neils95/Trivio/README.md

# Trivio
<h2>Boston University<br>
Jacob Dansey, Changshuo Fu, Christine Low, Urvashi Mohnani, Neil Sanghrajka</h2>
<br>

<h2>ReadMe Files</h2>

<h3>ReadmeFirst.docx</h3>
<p>Engineering Addendum outlining how to recreate our project.</p>

<h3>SoftwareREADME.md</h3>
<p>Documentation of the software components of our project.</p>

<h3>HardwareReadme.docx</h3>
<p>Documentation of the hardware components of our project.</p>

<br><br>
<h2>Folders</h2>

<h3>CAD Design</h3>
<p>Holds the Solidworks and STL files of the Trivio toy shell design.</p>

<h3>PCB Files</h3>
<p>Files related to PCB design and printing</p>

<h3>Reports</h3>
<p>Trivio Reports which include:</p>
<ul>
<li>Customer Installation Repor</li>
<li>First Deliverable Test Plan</li>
<li>First Deliverable Testing Report</li>
<li>First Semester Progress Report</li>
<li>Functional Testing Plan</li>
<li>Functional Testing Report</li>
<li>Gantchart</li>
<li>PDRR Report</li>
<li>Second Deliverable Test Plan</li>
<li>Second Deliverable Test Report</li>
<li>User's Manual</li>
</ul>

<h3>Server</h3>
<p>Code for the server</p>

<h3>Trivio Android App</h3>
<p>Code for the android application</p>

<h3>iOS_App</h3>
<p>Code for the iOS app</p>

<h3>Microprocessor</h3>
<p>Contains the Arduino code for the Trivio toy and the necessary libraries it uses.</p>
