neils95/Trivio/CAD Design/CAD Layout.pdf

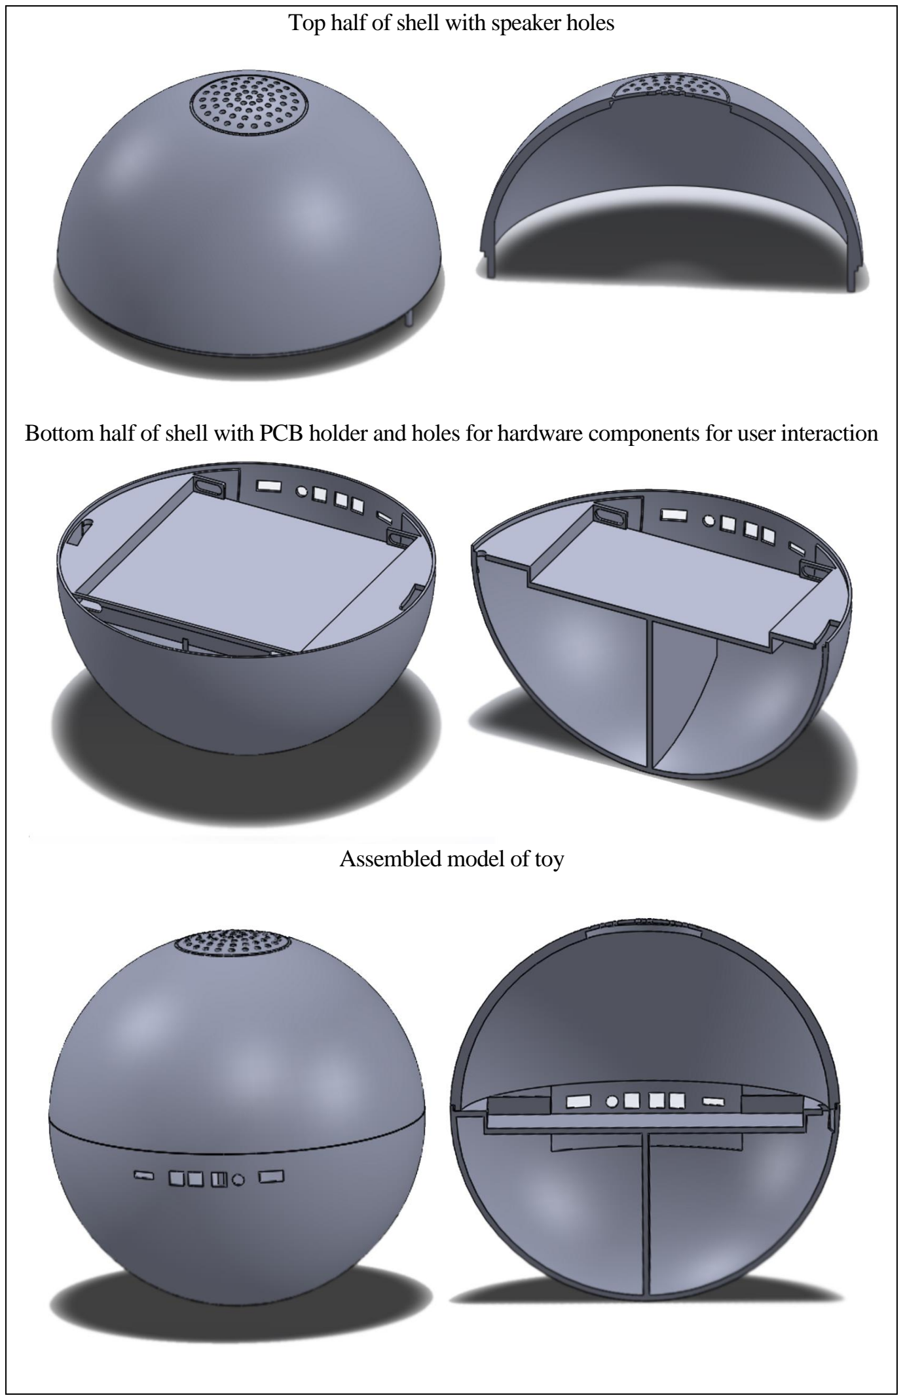
[picture p10: page 1]

Top half of shell with speaker holes

Bottom half of shell with PCB holder and holes for hardware components for user interaction

Assembled model of toy
