neils95/Trivio/Reports/Gantchart.docx

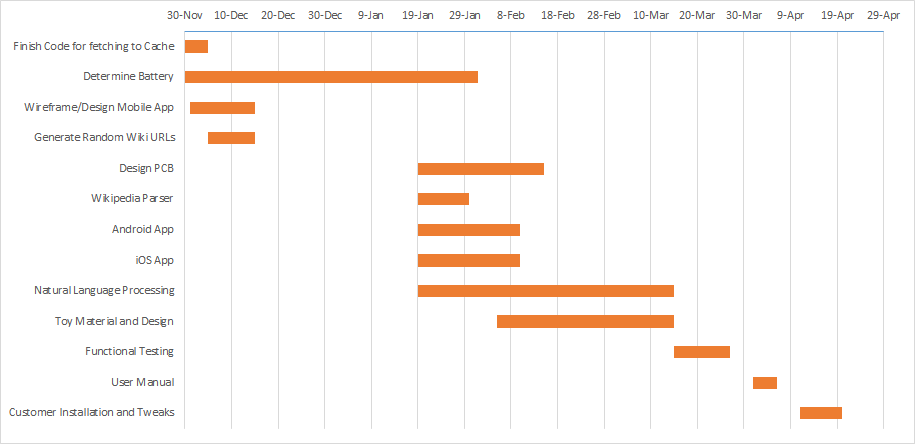
[picture p14: figure]
