neils95/Trivio/CAD Design/speakermount2.SLDPRT

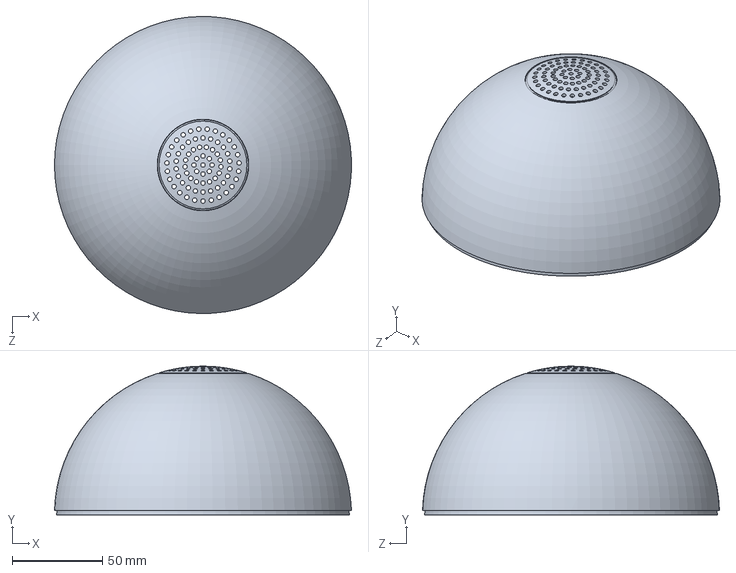
[picture p15: CAD file, 2017-04-26]
CAD Design/speakermount2.SLDPRT
164.5 x 82.3 x 164.5 mm
