neils95/Trivio/CAD Design/pcbmountshell.SLDPRT

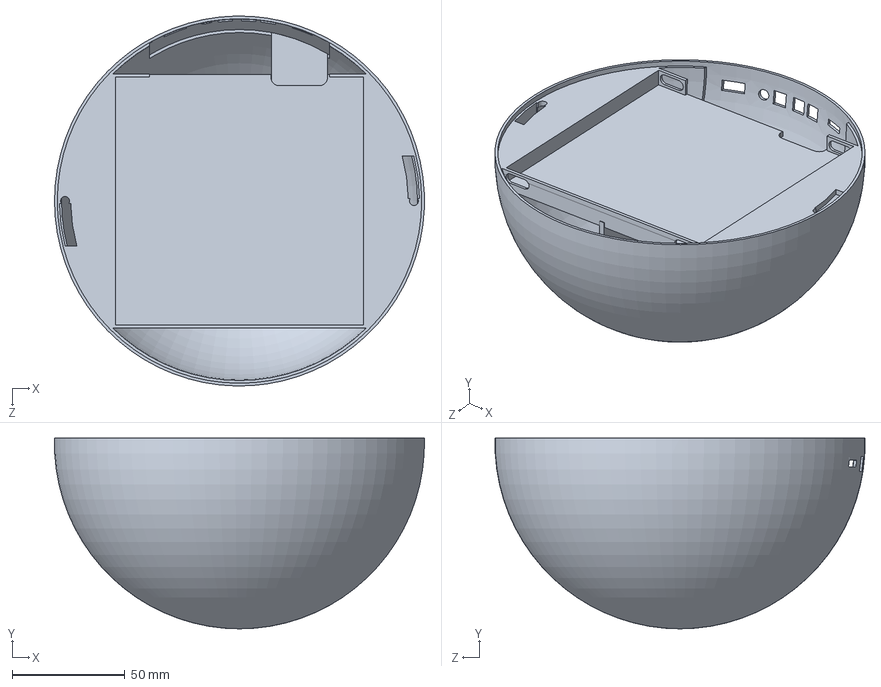
[picture p16: CAD file, 2017-04-26]
CAD Design/pcbmountshell.SLDPRT
164.4 x 84.8 x 164.4 mm
