neils95/Trivio/(list of files, cad)

Other CAD files:
CAD Design/speakermount.STL
CAD Design/pcbmountshell.STL
