neils95/Trivio/Server/Trivio/obj/Debug/_WPPLastBuildInfo.txt

PlatformName=AnyCPU
Configuration=Debug
WPPAllFilesInSingleFolder=C:\Users\neils\Documents\BU\Spring 2017\EC464\Code\Trivio\Server\Trivio\obj\Debug\Package\PackageTmp
WebPublishProfileFile=C:\Users\neils\Documents\BU\Spring 2017\EC464\Code\Trivio\Server\Trivio\Properties\PublishProfiles\Trivio - Web Deploy.pubxml
