neils95/Trivio/Server/Trivio/obj/Release/_WPPLastBuildInfo.txt

PlatformName=AnyCPU
Configuration=Release
WPPAllFilesInSingleFolder=C:\Users\neils\Documents\BU\Spring 2017\EC464\Code\Trivio\Server\Trivio\obj\Release\Package\PackageTmp
WebPublishProfileFile=C:\Users\neils\Documents\BU\Spring 2017\EC464\Code\Trivio\Server\Trivio\Properties\PublishProfiles\TrivioToy - Web Deploy (2).pubxml
