neils95/Trivio/(list of files, drawings)

Other design files:
PCB Files/PCB1.PcbDoc
PCB Files/PCB_Project.PrjPcb
PCB Files/Sheet3.SchDoc
PCB Files/Sheet4.SchDoc
