neils95/Trivio/microprocessor/ESP8266.cpp

/**
   @file ESP8266.cpp
   @brief The implementation of class ESP8266.
   @author Wu Pengfei<pengfei.wu@itead.cc>
   @date 2015.02

   @par Copyright:
   Copyright (c) 2015 ITEAD Intelligent Systems Co., Ltd. \n\n
   This program is free software; you can redistribute it and/or
   modify it under the terms of the GNU General Public License as
   published by the Free Software Foundation; either version 2 of
   the License, or (at your option) any later version. \n\n
   THE SOFTWARE IS PROVIDED "AS IS", WITHOUT WARRANTY OF ANY KIND, EXPRESS OR
   IMPLIED, INCLUDING BUT NOT LIMITED TO THE WARRANTIES OF MERCHANTABILITY,
   FITNESS FOR A PARTICULAR PURPOSE AND NONINFRINGEMENT. IN NO EVENT SHALL THE
   AUTHORS OR COPYRIGHT HOLDERS BE LIABLE FOR ANY CLAIM, DAMAGES OR OTHER
   LIABILITY, WHETHER IN AN ACTION OF CONTRACT, TORT OR OTHERWISE, ARISING FROM,
   OUT OF OR IN CONNECTION WITH THE SOFTWARE OR THE USE OR OTHER DEALINGS IN
   THE SOFTWARE.
*/
#include "ESP8266.h"

#define LOG_OUTPUT_DEBUG            (1)
#define LOG_OUTPUT_DEBUG_PREFIX     (1)

#define logDebug(arg)\
  do {\
    if (LOG_OUTPUT_DEBUG)\
    {\
      if (LOG_OUTPUT_DEBUG_PREFIX)\
      {\
        Serial.print("[LOG Debug: ");\
        Serial.print((const char*)__FILE__);\
        Serial.print(",");\
        Serial.print((unsigned int)__LINE__);\
        Serial.print(",");\
        Serial.print((const char*)__FUNCTION__);\
        Serial.print("] ");\
      }\
      Serial.print(arg);\
    }\
  } while(0)

#ifdef ESP8266_USE_SOFTWARE_SERIAL
ESP8266::ESP8266(SoftwareSerial &uart, uint32_t baud): m_puart(&uart)
{

}
#else
ESP8266::ESP8266(HardwareSerial &uart, uint32_t baud): m_puart(&uart)
{
  m_puart->begin(baud);
  rx_empty();
}
#endif

bool ESP8266::autoSetBaud(uint32_t baudRateSet)
{
  rx_empty();
  long time0 = millis();
  long baudRateArray[] = {9600, 19200, 57600, 115200}; //These are the optional default baudrates
  const int attempts = 5;
  bool baudFlag = 0;

#ifndef ESP8266_USE_SOFTWARE_SERIAL
  baudRateSet = 115200;                         //for hardware serial set to highest baudrate
#endif

  for (int j = 0 ; j < attempts ; j++) {                    //attempt to connect to esp over each baudrate
    for (int i = 0; i < sizeof(baudRateArray) ; i++)        //check for current esp baudrate
    {
      m_puart->begin(baudRateArray[i]);

      m_puart->println("AT");
      delay(20);
      while (m_puart->available()) {
        String inData = m_puart->readStringUntil('\n');
        if (inData.indexOf("OK") != -1) {       //if OK received, this is the current baudrate of the ESP
          baudFlag = 1;
          delay(15);
          break;
        }

      }
      if (baudFlag)
        break;
    }
    // ESP current BaudRate was found, now try to set it to 9600
    if (baudFlag) {
      baudFlag = 0;
      for (int j = 0; j < attempts; j++)               //at the found baudrate,
      {
        m_puart->print("AT+CIOBAUD=");
        m_puart->println(baudRateSet);
        delay(20);
        while (m_puart->available()) {
          String inData = m_puart->readStringUntil('\n');
          if (inData.indexOf("OK") != -1 || inData.indexOf("AT") != -1) {
            baudFlag = 1;
            m_puart->begin(baudRateSet);
            delay(100);
            return 1;
          }

        }
        if (baudFlag)
          break;
      }
    }

    if (baudFlag)
      break;
  }
  return 0;

}

//when using software serial BaudRate should be lower than 115200. 9600 works reliably
bool ESP8266::init(const String &ssid, const String &pwd, uint32_t baudRateSet)
{
  if (autoSetBaud(baudRateSet))
  {
    Serial.println("Baudrate set success");
  }
  else
  {
    Serial.println("Baudrate set failed");
    return false;
  }

  //Setting operation mode to Station + SoftAP
  if (setOprToStationSoftAP())
  {
    Serial.println("Station + softAP - OK");
  }
  else
  {
    Serial.println("Station + softAP - Error, Reset Board!");
    return false;
  }

  if (joinAP(ssid, pwd))
  {
    Serial.print("Joining AP successful, ");
    Serial.println(getLocalIP().c_str());
  }
  else
  {
    Serial.println("Join AP failure, Reset Board!");
    return false;
  }

  if (disableMUX())
  {
    Serial.println("Single Mode OK");
  }
  else
  {
    Serial.println("Single Mode Error, Reset Board!");
    return false;
  }
  return true;
}


bool ESP8266::kick(void)
{
  return eAT();
}

bool ESP8266::restart(void)
{
  unsigned long start;
  if (eATRST()) {
    delay(2000);
    start = millis();
    while (millis() - start < 3000) {
      if (eAT()) {
        delay(1500); /* Waiting for stable */
        return true;
      }
      delay(100);
    }
  }
  return false;
}

String ESP8266::getVersion(void)
{
  rx_empty();

  String inData;
  m_puart->println("AT+GMR");
  delay(50);
  while (m_puart->available() > 0) {
    inData = m_puart->readString();
    delay(50);
    if (inData.indexOf("version") != -1) {

      return inData.substring(6);    //cut version out of string
    }
  }
  return inData;


  String version;
  eATGMR(version);
  return version;
}

bool ESP8266::setOprToStation(void)
{
  uint8_t mode;
  if (!qATCWMODE(&mode)) {
    return false;
  }
  if (mode == 1) {
    return true;
  } else {
    if (sATCWMODE(1) && restart()) {
      return true;
    } else {
      return false;
    }
  }
}

bool ESP8266::setOprToSoftAP(void)
{
  uint8_t mode;
  if (!qATCWMODE(&mode)) {
    return false;
  }
  if (mode == 2) {
    return true;
  } else {
    if (sATCWMODE(2) && restart()) {
      return true;
    } else {
      return false;
    }
  }
}

bool ESP8266::setOprToStationSoftAP(void)
{
  uint8_t mode;
  if (!qATCWMODE(&mode)) {
    return false;
  }
  if (mode == 3) {
    return true;
  } else {
    if (sATCWMODE(3) && restart()) {
      return true;
    } else {
      return false;
    }
  }
}

String ESP8266::getAPList(void)
{
  String list;
  eATCWLAP(list);
  return list;
}

bool ESP8266::joinAP(String ssid, String pwd)
{
  return sATCWJAP(ssid, pwd);
}

bool ESP8266::leaveAP(void)
{
  return eATCWQAP();
}

bool ESP8266::setSoftAPParam(String ssid, String pwd, uint8_t chl, uint8_t ecn)
{
  return sATCWSAP(ssid, pwd, chl, ecn);
}

String ESP8266::getJoinedDeviceIP(void)
{
  String list;
  eATCWLIF(list);
  return list;
}

String ESP8266::getIPStatus(void)
{
  String list;
  eATCIPSTATUS(list);
  return list;
}

String ESP8266::getLocalIP(void)
{

  String inData;

  rx_empty();
  m_puart->println("AT+CIFSR");
  delay(50);
  while (m_puart->available() > 0) {
    inData = m_puart->readStringUntil('\n');
    if (inData.indexOf("IP") != -1) {
      delay(100);
      return ("IP: " + inData.substring( inData.indexOf("IP") + 4, inData.length() - 2 ));
    }
  }
  return "Couldn't get IP adress";

}

bool ESP8266::enableMUX(void)
{
  return sATCIPMUX(1);
}

bool ESP8266::disableMUX(void)
{
  rx_empty();
#ifdef ESP8266_USE_SOFTWARE_SERIAL
  String inData;
  m_puart->println("AT+CIPMUX=0");
  delay(50);
  while (m_puart->available() > 0) {
    inData = m_puart->readStringUntil('\n');
    if (inData.indexOf("OK") != -1) {
      delay(100);
      return true;
    }
  }
  return false;
#else
  return sATCIPMUX(0);
#endif

}

bool ESP8266::createTCP(String addr, uint32_t port)
{
  return sATCIPSTARTSingle("TCP", addr, port);
}


bool ESP8266::releaseTCP(void)
{
  rx_empty();
#ifdef ESP8266_USE_SOFTWARE_SERIAL

  String inData;
  m_puart->println("AT+CIPCLOSE");
  delay(50);
  while (m_puart->available() > 0) {
    inData = m_puart->readString();
    if (inData.indexOf("OK") != -1) {
      delay(100);
      return 1;
    }
  }
  return 0;
#else
  return eATCIPCLOSESingle();
#endif
}

bool ESP8266::registerUDP(String addr, uint32_t port)
{
  return sATCIPSTARTSingle("UDP", addr, port);
}

bool ESP8266::unregisterUDP(void)
{
  return eATCIPCLOSESingle();
}

bool ESP8266::createTCP(uint8_t mux_id, String addr, uint32_t port)
{
  return sATCIPSTARTMultiple(mux_id, "TCP", addr, port);
}

bool ESP8266::releaseTCP(uint8_t mux_id)
{
  return sATCIPCLOSEMulitple(mux_id);
}

bool ESP8266::registerUDP(uint8_t mux_id, String addr, uint32_t port)
{
  return sATCIPSTARTMultiple(mux_id, "UDP", addr, port);
}

bool ESP8266::unregisterUDP(uint8_t mux_id)
{
  return sATCIPCLOSEMulitple(mux_id);
}

bool ESP8266::setTCPServerTimeout(uint32_t timeout)
{
  return sATCIPSTO(timeout);
}

bool ESP8266::startTCPServer(uint32_t port)
{
  if (sATCIPSERVER(1, port)) {
    return true;
  }
  return false;
}

bool ESP8266::stopTCPServer(void)
{
  sATCIPSERVER(0);
  restart();
  return false;
}

bool ESP8266::startServer(uint32_t port)
{
  return startTCPServer(port);
}

bool ESP8266::stopServer(void)
{
  return stopTCPServer();
}

bool ESP8266::send(const uint8_t *buffer, uint32_t len)
{
  return sATCIPSENDSingle(buffer, len);
}



bool ESP8266::send(uint8_t mux_id, const uint8_t *buffer, uint32_t len)
{
  return sATCIPSENDMultiple(mux_id, buffer, len);
}

uint32_t ESP8266::recv(uint8_t *buffer, uint32_t buffer_size, uint32_t timeout)
{
  return recvPkg(buffer, buffer_size, NULL, timeout, NULL);
}



uint32_t ESP8266::recv(uint8_t mux_id, uint8_t *buffer, uint32_t buffer_size, uint32_t timeout)
{
  uint8_t id;
  uint32_t ret;
  ret = recvPkg(buffer, buffer_size, NULL, timeout, &id);
  if (ret > 0 && id == mux_id) {
    return ret;
  }
  return 0;
}

uint32_t ESP8266::recv(uint8_t *coming_mux_id, uint8_t *buffer, uint32_t buffer_size, uint32_t timeout)
{
  return recvPkg(buffer, buffer_size, NULL, timeout, coming_mux_id);
}

/*----------------------------------------------------------------------------*/
/* +IPD,<id>,<len>:<data> */
/* +IPD,<len>:<data> */

uint32_t ESP8266::recvPkg(uint8_t *buffer, uint32_t buffer_size, uint32_t *data_len, uint32_t timeout, uint8_t *coming_mux_id)
{
  String data;
  char a;
  int32_t index_PIPDcomma = -1;
  int32_t index_colon = -1; /* : */
  int32_t index_comma = -1; /* , */
  int32_t len = -1;
  int8_t id = -1;
  bool has_data = false;
  uint32_t ret;
  unsigned long start;
  uint32_t i;

  if (buffer == NULL) {
    return 0;
  }

  start = millis();
  while (millis() - start < timeout) {
    if (m_puart->available() > 0) {
      a = m_puart->read();
      data += a;
    }

    index_PIPDcomma = data.indexOf("+IPD,");
    if (index_PIPDcomma != -1) {
      index_colon = data.indexOf(':', index_PIPDcomma + 5);
      if (index_colon != -1) {
        index_comma = data.indexOf(',', index_PIPDcomma + 5);
        /* +IPD,id,len:data */
        if (index_comma != -1 && index_comma < index_colon) {
          id = data.substring(index_PIPDcomma + 5, index_comma).toInt();
          if (id < 0 || id > 4) {
            return 0;
          }
          len = data.substring(index_comma + 1, index_colon).toInt();
          if (len <= 0) {
            return 0;
          }
        } else { /* +IPD,len:data */
          len = data.substring(index_PIPDcomma + 5, index_colon).toInt();
          if (len <= 0) {
            return 0;
          }
        }
        has_data = true;
        break;
      }
    }
  }

  if (has_data) {
    i = 0;
    ret = len > buffer_size ? buffer_size : len;
    start = millis();
    while (millis() - start < 3000) {
      while (m_puart->available() > 0 && i < ret) {
        a = m_puart->read();
        buffer[i++] = a;
      }
      if (i == ret) {
        rx_empty();
        if (data_len) {
          *data_len = len;
        }
        if (index_comma != -1 && coming_mux_id) {
          *coming_mux_id = id;
        }
        return ret;
      }
    }
  }
  return 0;
}

void ESP8266::rx_empty(void)
{
  while (m_puart->available() > 0) {
    m_puart->read();
  }
}

String ESP8266::recvString(String target, uint32_t timeout)
{
  String data;
  char a;
  unsigned long start = millis();
  while (millis() - start < timeout) {
    while (m_puart->available() > 0) {
      a = m_puart->read();
      if (a == '\0') continue;
      data += a;
    }
    if (data.indexOf(target) != -1) {
      break;
    }
  }
  return data;
}

String ESP8266::recvString(String target1, String target2, uint32_t timeout)
{
  String data;
  char a;
  unsigned long start = millis();
  while (millis() - start < timeout) {
    while (m_puart->available() > 0) {
      a = m_puart->read();
      if (a == '\0') continue;
      data += a;
    }
    if (data.indexOf(target1) != -1) {
      break;
    } else if (data.indexOf(target2) != -1) {
      break;
    }
  }
  return data;
}

String ESP8266::recvString(String target1, String target2, String target3, uint32_t timeout)
{
  String data;
  char a;
  unsigned long start = millis();
  while (millis() - start < timeout) {
    while (m_puart->available() > 0) {
      a = m_puart->read();
      if (a == '\0') continue;
      data += a;
    }
    if (data.indexOf(target1) != -1) {
      break;
    } else if (data.indexOf(target2) != -1) {
      break;
    } else if (data.indexOf(target3) != -1) {
      break;
    }
  }
  return data;
}

bool ESP8266::recvFind(String target, uint32_t timeout)
{
  String data_tmp;
  data_tmp = recvString(target, timeout);
  if (data_tmp.indexOf(target) != -1) {
    return true;
  }
  return false;
}

bool ESP8266::recvFindAndFilter(String target, String begin, String end, String & data, uint32_t timeout)
{
  String data_tmp;
  data_tmp = recvString(target, timeout);
  if (data_tmp.indexOf(target) != -1) {
    int32_t index1 = data_tmp.indexOf(begin);
    int32_t index2 = data_tmp.indexOf(end);
    if (index1 != -1 && index2 != -1) {
      index1 += begin.length();
      data = data_tmp.substring(index1, index2);
      return true;
    }
  }
  data = "";
  return false;
}

bool ESP8266::eAT(void)
{
  rx_empty();
  m_puart->println("AT");
  return recvFind("OK");
}

bool ESP8266::eATRST(void)
{
  rx_empty();
  m_puart->println("AT+RST");
  return recvFind("OK");
}

bool ESP8266::eATGMR(String & version)
{
  rx_empty();
  m_puart->println("AT+GMR");
  return recvFindAndFilter("OK", "\r\r\n", "\r\n\r\nOK", version);
}

bool ESP8266::qATCWMODE(uint8_t *mode)
{
  String str_mode;
  bool ret;
  if (!mode) {
    return false;
  }
  rx_empty();
  m_puart->println("AT+CWMODE?");
  ret = recvFindAndFilter("OK", "+CWMODE:", "\r\n\r\nOK", str_mode);
  if (ret) {
    *mode = (uint8_t)str_mode.toInt();
    return true;
  } else {
    return false;
  }
}

bool ESP8266::sATCWMODE(uint8_t mode)
{
  String data;
  rx_empty();
  m_puart->print("AT+CWMODE=");
  m_puart->println(mode);

  data = recvString("OK", "no change");
  if (data.indexOf("OK") != -1 || data.indexOf("no change") != -1) {
    return true;
  }
  return false;
}

bool ESP8266::sATCWJAP(String ssid, String pwd)
{
  String data;
  rx_empty();
  m_puart->print("AT+CWJAP=\"");
  m_puart->print(ssid);
  m_puart->print("\",\"");
  m_puart->print(pwd);
  m_puart->println("\"");

  data = recvString("OK", "FAIL", 10000);
  if (data.indexOf("OK") != -1) {
    return true;
  }
  return false;
}

bool ESP8266::eATCWLAP(String & list)
{
  String data;
  rx_empty();
  m_puart->println("AT+CWLAP");
  return recvFindAndFilter("OK", "\r\r\n", "\r\n\r\nOK", list, 10000);
}

bool ESP8266::eATCWQAP(void)
{
  String data;
  rx_empty();
  m_puart->println("AT+CWQAP");
  return recvFind("OK");
}

bool ESP8266::sATCWSAP(String ssid, String pwd, uint8_t chl, uint8_t ecn)
{
  String data;
  rx_empty();
  m_puart->print("AT+CWSAP=\"");
  m_puart->print(ssid);
  m_puart->print("\",\"");
  m_puart->print(pwd);
  m_puart->print("\",");
  m_puart->print(chl);
  m_puart->print(",");
  m_puart->println(ecn);

  data = recvString("OK", "ERROR", 5000);
  if (data.indexOf("OK") != -1) {
    return true;
  }
  return false;
}

bool ESP8266::eATCWLIF(String & list)
{
  String data;
  rx_empty();
  m_puart->println("AT+CWLIF");
  return recvFindAndFilter("OK", "\r\r\n", "\r\n\r\nOK", list);
}

bool ESP8266::eATCIPSTATUS(String & list)
{
  String data;
  delay(100);
  rx_empty();
  m_puart->println("AT+CIPSTATUS");
  return recvFindAndFilter("OK", "\r\r\n", "\r\n\r\nOK", list);
}

bool ESP8266::sATCIPSTARTSingle(String type, String addr, uint32_t port)
{
  String data;
  rx_empty();
  m_puart->print("AT+CIPSTART=\"");
  m_puart->print(type);
  m_puart->print("\",\"");
  m_puart->print(addr);
  m_puart->print("\",");
  m_puart->println(port);

  data = recvString("OK", "ERROR", "ALREADY CONNECT", 500);
  if (data.indexOf("OK") != -1 || data.indexOf("ALREADY CONNECT") != -1) {
    return true;
  }
  return false;
}

bool ESP8266::sATCIPSTARTMultiple(uint8_t mux_id, String type, String addr, uint32_t port)
{
  String data;
  rx_empty();
  delay(50);
  m_puart->print("AT+CIPSTART=");
  m_puart->print(mux_id);
  m_puart->print(",\"");
  m_puart->print(type);
  m_puart->print("\",\"");
  m_puart->print(addr);
  m_puart->print("\",");
  m_puart->println(port);

  data = recvString("OK", "ERROR", "ALREADY CONNECT", 10000);
  if (data.indexOf("OK") != -1 || data.indexOf("ALREADY CONNECT") != -1) {
    return true;
  }
  return false;
}

bool ESP8266::sATCIPSENDSingle(const uint8_t *buffer, uint32_t len)
{
  rx_empty();
  m_puart->print("AT+CIPSEND=");
  m_puart->println(len);
  if (recvFind(">", 5000)) {
    rx_empty();
    for (uint32_t i = 0; i < len; i++) {
      m_puart->write(buffer[i]);
    }
    return recvFind("SEND OK", 10000);
  }
  return false;
}

bool ESP8266::sATCIPSENDMultiple(uint8_t mux_id, const uint8_t *buffer, uint32_t len)
{
  rx_empty();
  m_puart->print("AT+CIPSEND=");
  m_puart->print(mux_id);
  m_puart->print(",");
  m_puart->println(len);
  if (recvFind(">", 5000)) {
    rx_empty();
    for (uint32_t i = 0; i < len; i++) {
      m_puart->write(buffer[i]);
    }
    return recvFind("SEND OK", 10000);
  }
  return false;
}
bool ESP8266::sATCIPCLOSEMulitple(uint8_t mux_id)
{
  String data;
  rx_empty();
  m_puart->print("AT+CIPCLOSE=");
  m_puart->println(mux_id);

  data = recvString("OK", "link is not", 5000);
  if (data.indexOf("OK") != -1 || data.indexOf("link is not") != -1) {
    return true;
  }
  return false;
}
bool ESP8266::eATCIPCLOSESingle(void)
{

  rx_empty();
  m_puart->println("AT+CIPCLOSE");
  return recvFind("OK", 5000);
}
bool ESP8266::eATCIFSR(String & list)
{
  rx_empty();
  m_puart->println("AT+CIFSR");
  return recvFindAndFilter("OK", "\r\r\n", "\r\n\r\nOK", list);
}
bool ESP8266::sATCIPMUX(uint8_t mode)
{
  String data;

  rx_empty();
  delay(100);
  m_puart->print("AT+CIPMUX=");
  m_puart->println(mode);

  data = recvString("OK", "Link is builded");
  if (data.indexOf("OK") != -1) {
    delay(100);
    return true;
  }
  return false;
}
bool ESP8266::sATCIPSERVER(uint8_t mode, uint32_t port)
{
  String data;
  if (mode) {
    rx_empty();
    m_puart->print("AT+CIPSERVER=1,");
    m_puart->println(port);

    data = recvString("OK", "no change");
    if (data.indexOf("OK") != -1 || data.indexOf("no change") != -1) {
      return true;
    }
    return false;
  } else {
    rx_empty();
    m_puart->println("AT+CIPSERVER=0");
    return recvFind("\r\r\n");
  }
}
bool ESP8266::sATCIPSTO(uint32_t timeout)
{
  rx_empty();
  m_puart->print("AT+CIPSTO=");
  m_puart->println(timeout);
  return recvFind("OK");
}



bool ESP8266::sendSingle(const char* url)
{
  rx_empty();
  m_puart->print("AT+CIPSEND=");
  m_puart->println(strlen(url));
  if (recvFind(">", 500)) {
    rx_empty();
    m_puart->print(url);


    return recvFind("SEND OK", 500);
  }
  else
    return false;
}


int ESP8266::recvSingle(uint8_t *buffer, int bufferLen)
{
  int i = 0;
  int bodyFlag = 1;
#ifndef ESP8266_USE_SOFTWARE_SERIAL
String inData = "";
#endif

  unsigned long start = millis();
  while (millis() - start < 500) {
    while (m_puart->available() > 0 && i < bufferLen)
    {
      //when using software serial due to buffer issues read incoming string char by char
#ifdef ESP8266_USE_SOFTWARE_SERIAL
      char c = m_puart->read();
      buffer[i++] = c;
#else
      inData += m_puart->readStringUntil('\n');

#endif
    }

    if (i == bufferLen && m_puart->available()) {
      Serial.println(F("buffer is full!"));
      return i - 1;
    }
  }

  return i - 1;
}
int ESP8266::httpGet()
{
  char* request =  "GET / HTTP/1.1\r\nHost: www.google.com\r\nConnection: close\r\n\r\n";

  if (createTCP("www.google.com", 80))
  {
    Serial.println(F("create tcp - OK"));
  }
  else
  {
    Serial.println(F("create tcp - ERROR"));
    return "";
  }

  if (!sendSingle(request))
  {
    Serial.print(F("not sent"));
    //return "";
  }

  int len = recvSingle(m_responseBuffer, MAX_BUFFER_SIZE);
  Serial.println((char*)m_responseBuffer);


  return len;
}
