neils95/Trivio/(commit log)

2016-10-31 acceleration code for arduino
2016-11-11 merged TTS, accelerometer, and caching functions together
2016-11-18 fixed faulty strings that could not be read. stored index of last read fact
    [microprocessor.ino]
2017-02-16 socket connection
2017-02-28 socket server
2017-03-04 Updated to camel case
2017-03-21 code for keeping track of how many facts has been played since last server pull
2017-03-25 fixed sd card reader
    [microprocessor.ino]
2017-03-25 With libraries
    [l.obj]
2017-03-25 remove massive folder
    [l.obj]
2017-04-05 fixed some stuff with combining?
    [microprocessor.ino]
2017-04-07 fixed socket server
2017-04-07 updated socket server
2017-04-12 battery level
2017-04-19 working pcb test
2017-04-21 led update
2017-04-26 cad designs
    [pcbmountshell.SLDPRT, pcbmountshell.STL, speakermount.STL, speakermount2.SLDPRT]
2017-05-01 PCB Files
    Schematics and Layout for the PCB
    [PCB1.PcbDoc, PCB_Project.PrjPcb, Sheet3.SchDoc, Sheet4.SchDoc]
